dmhuisma/zmk_universal_remote/board/universal_remote.kicad_pcb

## KiCad design board/universal_remote.kicad_pcb (2026-11-10)

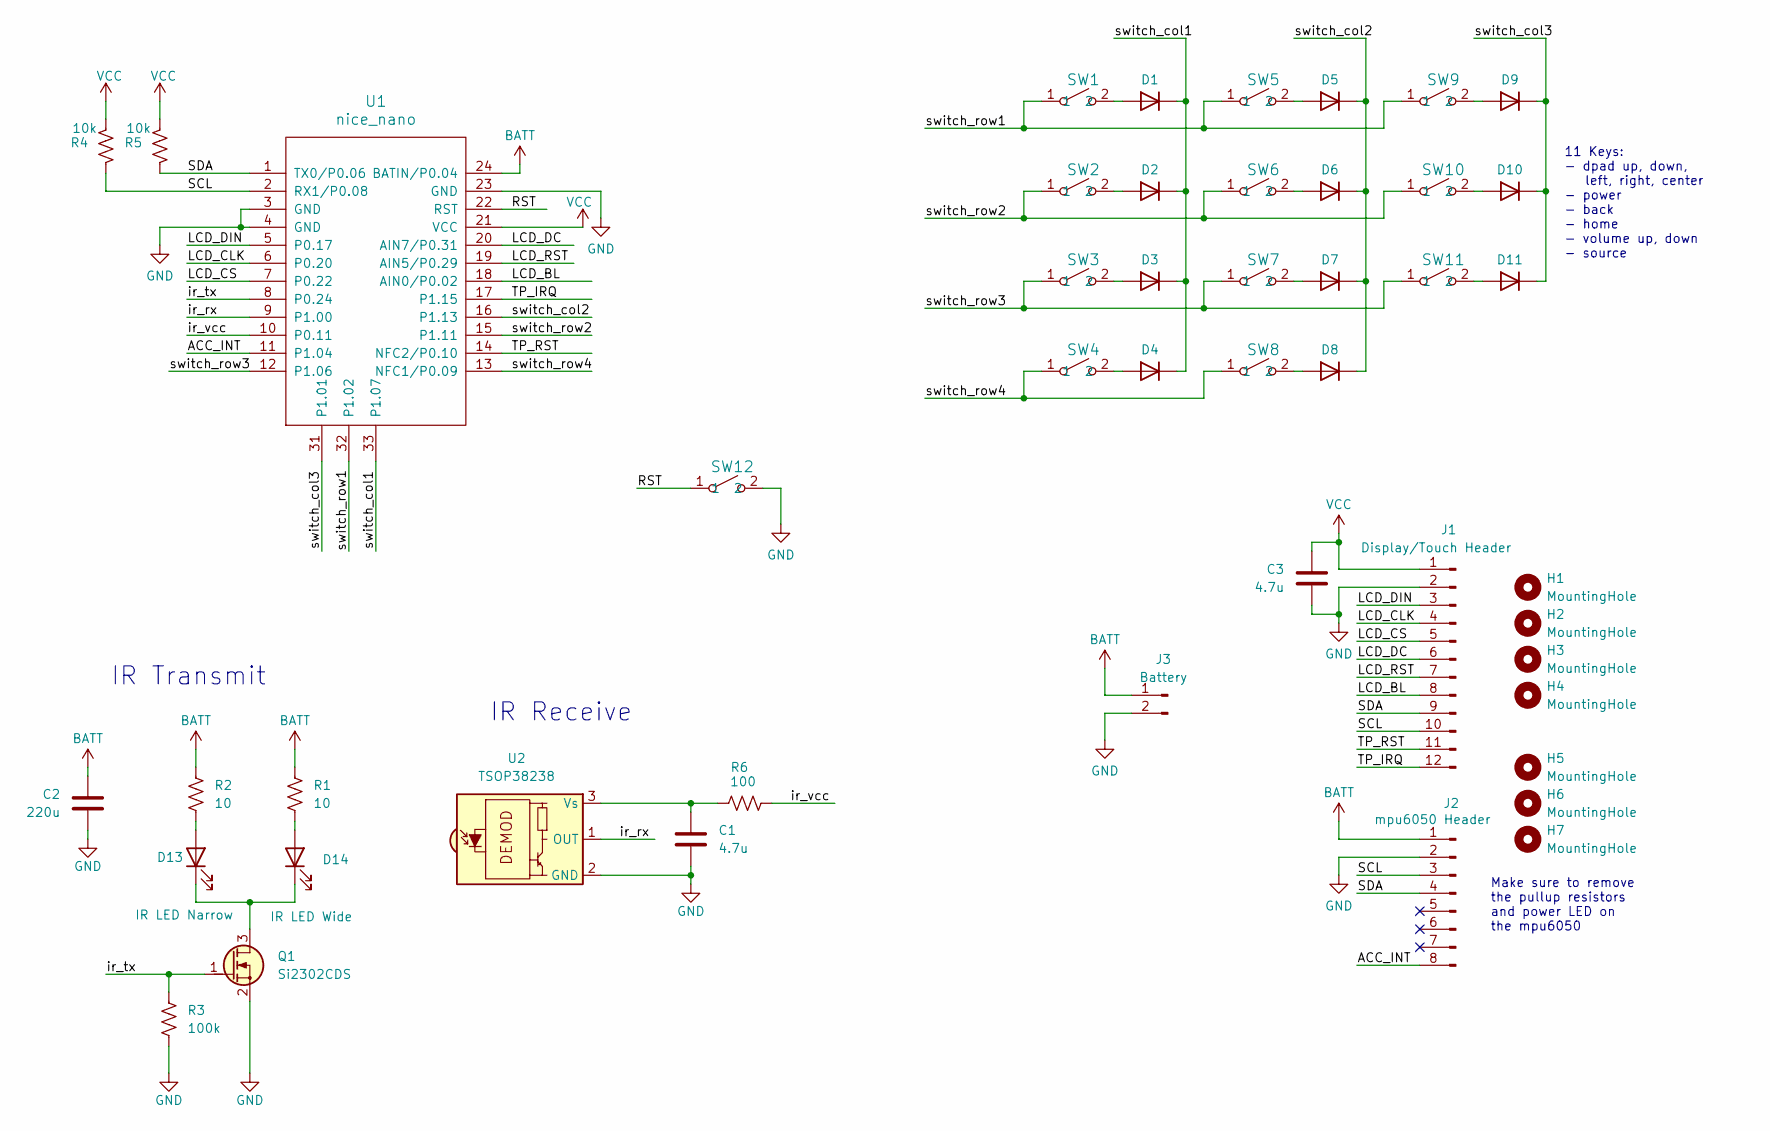
[picture p1: schematic universal_remote.kicad_sch]

Parts:
C1, C3: 4.7u; C_0603_1608Metric_Pad1.08x0.95mm_HandSolder
C2: 220u; C_1210_3225Metric_Pad1.33x2.70mm_HandSolder
D1, D2, D3, D4, D5, D6, D7, D8, D9, D10, D11: D; D_DO-35_SOD27_P10.16mm_Horizontal
D13: IR LED Narrow; LED_D5.0mm
D14: IR LED Wide; LED_D5.0mm
H1, H2, H3, H4: MountingHole; MountingHole_2.2mm_M2
H5, H6, H7: MountingHole; MountingHole_3.2mm_M3
J1: Display/Touch Header; PinHeader_1x12_P2.54mm_Vertical
J2: mpu6050 Header; PinHeader_1x08_P2.54mm_Vertical
J3: Battery; PinHeader_1x02_P2.54mm_Vertical
Q1: Si2302CDS; SOT-23
R1, R2: 10; R_1206_3216Metric_Pad1.30x1.75mm_HandSolder
R3: 100k; R_0603_1608Metric_Pad0.98x0.95mm_HandSolder
R4, R5: 10k; R_0603_1608Metric_Pad0.98x0.95mm_HandSolder
R6: 100; R_0603_1608Metric_Pad0.98x0.95mm_HandSolder
SW1, SW2, SW3, SW4, SW5, SW6, SW7, SW8, SW9, SW10, SW11, SW12: SKPMAME010; SKPMAME010_ALPS
U1: nice_nano
U2: TSOP38238; Vishay_MINICAST-3Pin

Connections:
/ACC_INT: J2.8, U1.11 (P1.04)
/LCD_BL: J1.8, U1.18 (AIN0/P0.02)
/LCD_CLK: J1.4, U1.6 (P0.20)
/LCD_CS: J1.5, U1.7 (P0.22)
/LCD_DC: J1.6, U1.20 (AIN7/P0.31)
/LCD_DIN: J1.3, U1.5 (P0.17)
/LCD_RST: J1.7, U1.19 (AIN5/P0.29)
/RST: SW12.1, U1.22 (RST)
/SCL: J1.10, J2.3, R4.2, U1.2 (RX1/P0.08)
/SDA: J1.9, J2.4, R5.2, U1.1 (TX0/P0.06)
/TP_IRQ: J1.12, U1.17 (P1.15)
/TP_RST: J1.11, U1.14 (NFC2/P0.10)
/ir_rx: U1.9 (P1.00), U2.1 (OUT)
/ir_tx: Q1.1 (G), R3.2, U1.8 (P0.24)
/ir_vcc: R6.2, U1.10 (P0.11)
/switch_col1: D1.1 (K), D2.1 (K), D3.1 (K), D4.1 (K), U1.33 (P1.07)
/switch_col2: D5.1 (K), D6.1 (K), D7.1 (K), D8.1 (K), U1.16 (P1.13)
/switch_col3: D9.1 (K), D10.1 (K), D11.1 (K), U1.31 (P1.01)
/switch_row1: SW1.1, SW5.1, SW9.1, U1.32 (P1.02)
/switch_row2: SW2.1, SW6.1, SW10.1, U1.15 (P1.11)
/switch_row3: SW3.1, SW7.1, SW11.1, U1.12 (P1.06)
/switch_row4: SW4.1, SW8.1, U1.13 (NFC1/P0.09)
BATT: C2.2, J2.1, J3.1, R1.1, R2.1, U1.24 (BATIN/P0.04)
GND: C1.2, C2.1, C3.1, J1.2, J2.2, J3.2, Q1.2 (S), R3.1, SW12.2, U1.3 (GND), U1.4 (GND), U1.23 (GND), U2.2 (GND)
unnamed: D1.2 (A), SW1.2
unnamed: D2.2 (A), SW2.2
unnamed: D3.2 (A), SW3.2
unnamed: D4.2 (A), SW4.2
unnamed: D5.2 (A), SW5.2
unnamed: D6.2 (A), SW6.2
unnamed: D7.2 (A), SW7.2
unnamed: D8.2 (A), SW8.2
unnamed: D9.2 (A), SW9.2
unnamed: D10.2 (A), SW10.2
unnamed: D11.2 (A), SW11.2
unnamed: D13.2 (A), R2.2
unnamed: D13.1 (K), D14.1 (K), Q1.3 (D)
unnamed: D14.2 (A), R1.2
unnamed: C1.1, R6.1, U2.3 (Vs)
VCC: C3.2, J1.1, R4.1, R5.1, U1.21 (VCC)

Notes on the sheet:
IR Receive
Make sure to remove the pullup resistors and power LED on the mpu6050
11 Keys: - dpad up, down, left, right, center - power - back - home - volume up, down - source
IR Transmit

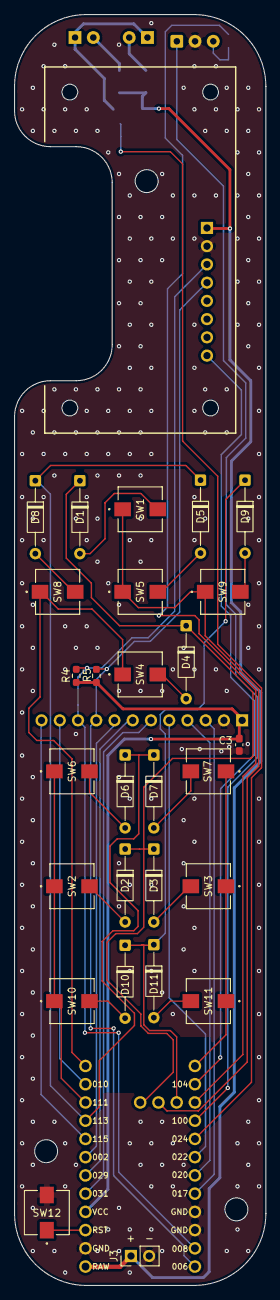
[picture p2: board universal_remote.kicad_pcb from above]

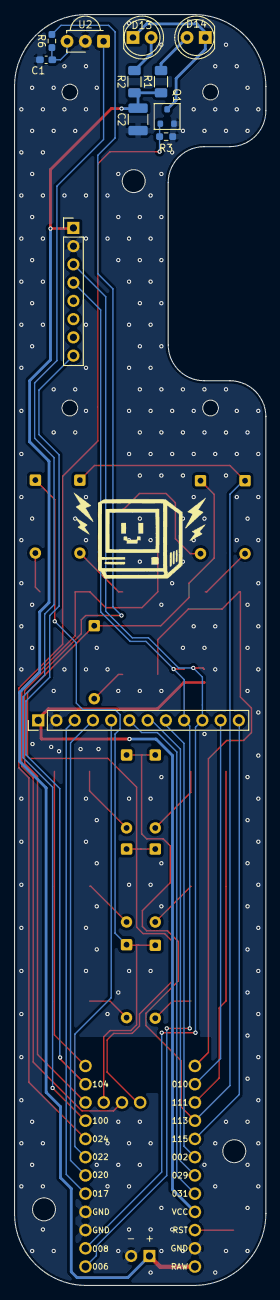
[picture p3: board universal_remote.kicad_pcb from below]

Board: 2 copper layers, 35.0 x 177.0 mm, 47 parts (12 on the bottom side), 40 nets.
